NIDcornifleur/RB2/maps_2026-06-20/rb2_map_20260620-125016.png

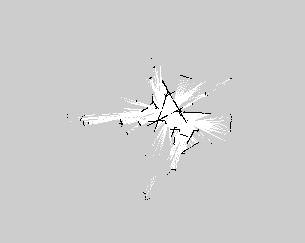
maps_2026-06-20/rb2_map_20260620-125016.png
