NIDcornifleur/RB2/docs/VERIFICATIONS_CODE_20260626.md

\# Vérifications code RB2 - 2026-06-26

\## Objectif

Documenter les vérifications effectuées pendant le nettoyage prudent du dépôt RB2.

Branche utilisée :

\- nettoyage-codex-20260626

\## Vérification syntaxique Python

Les fichiers suivants ont été vérifiés avec python -m py\_compile :

\- opt/rb2/esp32\_panel.py

\- opt/rb2/rb2\_esp32.py

\- opt/rb2/rb2\_lidar\_json.py

\- opt/rb2/rb2\_lidar\_map\_json.py

\- opt/rb2/rb2\_imu\_json.py

\- opt/rb2/rb2\_usb\_camera.py

\- opt/rb2/rb2\_wifi\_dual\_loss\_return.py

Résultat :

\- aucune erreur bloquante;

\- les fichiers compilent.

\## Avertissement corrigé ou déjà résolu

Un avertissement Python avait été observé dans opt/rb2/esp32\_panel.py :

\- SyntaxWarning: invalid escape sequence '\\d'

Ligne JavaScript concernée :

\- return /^d-?\\d+,-?\\d+$/.test(String(command || ""));

État final vérifié :

\- return /^d-?\\\\d+,-?\\\\d+$/.test(String(command || ""));

Cette forme évite l'avertissement Python tout en conservant le sens de l'expression régulière JavaScript générée.

\## État Git final

Après vérification :

\- git status propre;

\- aucun fichier \_\_pycache\_\_ conservé;

\- aucun changement non commité.

\## Conclusion

Le dépôt est dans un état propre après les vérifications syntaxiques.

Aucune logique moteur, STOP, LIDAR, SLAM, caméra, trace ou réseau n'a été modifiée volontairement.
