NIDcornifleur/RB2/docs/VALIDATION_2026-06-20_SLAM_TERRAIN_OK.md

# Validation RB2 — Parcours SLAM terrain réussi

Date : 2026-06-20

## Résultat

Petit parcours SLAM effectué avec succès depuis la page Terrain.

État confirmé :

- Démarrage SLAM depuis les boutons existants de la page Terrain
- Trace démarrée
- Parcours effectué sans hésitation
- Aucun délai anormal moteur ou pan-tilt
- Carte sauvegardée
- PNG téléchargé avec succès

## Conclusion

La chaîne SLAM manuelle est fonctionnelle pour un petit parcours terrain :

/scan
/imu
/wheel_ticks
/odom
slam_toolbox
/map
sauvegarde carte
téléchargement PNG

Cet état est considéré comme stable.
