NIDcornifleur/RB2/docs/VALIDATION_DEPLOIEMENT_PI5_20260626.md

# Validation déploiement Pi5 RB2 - 2026-06-26

## Contexte

Déploiement sur le Pi5 RB2 après fusion du nettoyage Codex prudent dans main.

Commit validé :

- 796d383 Fusionne nettoyage Codex prudent RB2

Tag main :

- rb2-main-apres-nettoyage-codex-20260626

## Sauvegarde préalable

Une sauvegarde de production a été faite avant déploiement :

- /opt/rb2_backups/rb2_avant_main_nettoyage_20260626

## Résultat après déploiement

Fonctions validées :

- caméra : OK
- pan/tilt : OK
- lumières : OK
- relais : OK
- LIDAR : OK
- roues : OK

Fonction connue comme instable :

- IMU : inactif/intermittent, remplacement prévu

## Conclusion

Le déploiement du nettoyage Codex prudent sur le Pi5 est validé.

Aucun rollback nécessaire.

Le dépôt main et /opt/rb2 sont considérés comme conformes après validation terrain de base.
