NIDcornifleur/RB2/docs/VALIDATION_2026-06-20_SLAM_TERRAIN_PNG_OK.md

# Validation RB2 — SLAM terrain avec téléchargement PNG OK

Date : 2026-06-20

## État validé

Le parcours terrain avec SLAM manuel a été réussi.

État ROS confirmé avant parcours :

- slam_toolbox : active [3]
- /scan présent
- /imu présent
- /odom présent
- /map présent
- /map_metadata présent
- /pose présent
- /slam_toolbox/scan_visualization présent

## Interface web

Page utilisée :

- /terrain

Boutons utilisés :

- DÉMARRER SLAM
- DÉMARRER TRACE, si utilisé
- SAUVEG.
- TÉLÉCH. PNG
- ARRÊTER TRACE, si utilisé

Résultat :

- carte générée;
- PNG téléchargé avec succès;
- parcours SLAM fonctionnel.

## Correction importante

La route /slam_start a été simplifiée pour éviter de bloquer l'interface web.

Ancien comportement :

- /slam_start attendait trop longtemps la configuration complète de slam_toolbox;
- le navigateur pouvait dépasser 45 secondes;
- les boutons SLAM/CARTE restaient gelés jusqu'au rafraîchissement.

Nouveau comportement :

- /slam_start lance /usr/local/sbin/rb2-slam-start-bg en arrière-plan;
- la réponse web revient rapidement;
- /slam_status continue de suivre l'état réel du SLAM;
- slam_toolbox finit en active [3].

## Fichiers sauvegardés

- /opt/rb2/esp32_panel.py
- /usr/local/sbin/rb2-slam-start-bg
- /etc/sudoers.d/rb2-slam-start-bg
- cartes du jour dans maps_2026-06-20/

## État recommandé pour les prochains essais

- utiliser le mode terrain AP seulement;
- vérifier que slam_toolbox est active [3] avant de rouler;
- conduire lentement;
- faire des pauses de 1 seconde entre les mouvements;
- éviter les grands pivots rapides pendant les validations SLAM.
