NIDcornifleur/RB2/(commit log)

2026-06-18 État stable RB2 caméra Ethernet et LIDAR OK
2026-06-18 Ajoute code source ESP32 RB2
2026-06-19 Etat stable apres limites pan camera et retour avertissement LIDAR
2026-06-19 Corrige limites pan tilt ESP32
    [RB2_ESP32_WROOM_Moteurs_PanTilt_Encodeurs.ino]
2026-06-20 Valide SLAM manuel et pont wheel ticks JSON
2026-06-20 Ajoute bouton Restart Camera pour Zero 2 W
2026-06-26 Ajoute inventaire de nettoyage Codex
2026-06-26 Documente empreintes SHA256 des dossiers opt
2026-06-26 Ajoute preuve production lidar map json
2026-06-26 Ajoute version production lidar map json dans opt rb2
2026-06-26 Ajoute scripts systemd de production
2026-06-26 Corrige modes executables des scripts RB2
    [rb2_lidar_map_json.py]
2026-06-26 Ajoute rapport de nettoyage structurel
2026-06-26 Documente analyse esp32_panel
2026-06-26 Documente routes Flask esp32_panel
2026-06-26 Documente constantes sensibles esp32_panel
2026-06-26 Documente dependances esp32_panel
2026-06-26 Ajoute module ESP32 de production
2026-06-26 Documente module ESP32 de production
2026-06-26 Documente micro-corrections esp32_panel
2026-06-26 Ajoute watchdog LIDAR ROS
2026-07-06 Ajoute lidar_drive2 avec boutons sous carte et panneau compact
2026-07-06 Remplace pont IMU par lecture BNO055
2026-07-12 Route LIDAR controls to lidar_drive2
2026-07-14 Intègre /terrain4 dans l'arborescence canonique et corrige ses bugs
    - opt/rb2/esp32_panel.py : ajoute la route /terrain4 (page autonome,
    déjà en production, jamais synchronisée avec le dépôt).
    - opt/rb2/terrain4.html (nouveau) : remplace les copies non suivies
    terrain4.html et esp32_panel_RB2_terrain4.py à la racine.
    - Corrige fetchJson() qui référençait une variable "started" jamais
    déclarée, provoquant une erreur sur chaque appel (lumière, relais 2,
    carte LIDAR, statut vidéo) malgré des réponses serveur valides.
    - Applique le correctif réseau v2.1 (délais rallongés, resynchronisation
    GPIO, carte LIDAR à 2 s).
    - Réorganise l'en-tête : lumière/relais 2/arrêt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
2026-07-14 Ajoute un bouton RETOUR vers /terrain4 sur /lidar_drive2
    Le bouton est placé à côté du badge « RB2 : OK » dans le panneau État
    RB2, qui est rétréci pour lui laisser la place. Changement scopé à la
    route /lidar_drive2 (ne touche pas /lidar_drive, qui partage le même
    gabarit de base LIDAR_DRIVE_HTML).
    Testé et validé en direct sur RB2.
2026-07-14 Corrige le lien Retour de /secours vers /terrain4
    Les deux liens "Retour /terrain" de la page /secours pointaient encore
    vers l'ancienne page /terrain. Mis à jour vers /terrain4.
    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
2026-07-14 Reconnaît /terrain4 dans le nettoyage des doublons Retour sur /secours
    isTerrainReturn() ne reconnaissait que href === "/terrain" pour
    détecter et retirer les liens "Retour terrain" en double hors de la
    barre de titre. Depuis le passage de ces liens vers /terrain4, le
    doublon n'était plus nettoyé côté client.
    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
2026-07-14 Rétablit le glissement entre boutons moteur sur terrain4
    Avant, il fallait relâcher un bouton moteur puis en cliquer un autre
    pour changer de direction. Les pages précédentes (lidar_drive2)
    permettaient de glisser d'un bouton à l'autre sans décliquer via
    elementFromPoint sur mousemove/touchmove ; terrain4 avait perdu cette
    logique en passant à pointerdown/pointerup + setPointerCapture.
    Ajoute un gestionnaire pointermove par bouton qui détecte, via
    elementFromPoint, le bouton survolé et change de direction seulement
    si elle diffère de la direction active (state.driveDirection).
2026-07-18 Ajoute la bascule Wi-Fi 2,4G/5G sur terrain4 avec retour visuel
    Boutons wifi24gBtn/wifi5gBtn : script rb2-wifi-mode (wifi_24g/wifi_5g),
    routes /rb2_network/wifi_24g et /wifi_5g, et détection SSID/bande
    (iwgetid avec repli nmcli) exposée par /rb2_network/status. Le bouton
    actif passe en vert; un clic sonde le statut jusqu'à confirmation de
    la bande (jusqu'à 20 s, la ré-association + DHCP n'étant pas
    instantanés) avant d'afficher ERREUR en cas d'échec réel.
2026-07-21 Corrige le double-shutdown rclpy dans les ponts JSON LIDAR
    rb2-lidar-watchdog redémarre ces services via systemctl restart quand
    le JSON devient stale, ce qui envoie SIGTERM. Le handler de signal de
    rclpy invalide alors le contexte avant que le finally: rclpy.shutdown()
    explicite ne s'exécute, provoquant un RCLError ("rcl_shutdown already
    called") et un crash au lieu d'un arrêt propre. 14 crashes observés le
    2026-07-21 entre 08:41 et 09:06, laissant back_cm intermittent/absent
    et bloquant gauche/droite/recul via la garde LIDAR de rb2_safe_drive_send.
    [rb2_lidar_json.py, rb2_lidar_map_json.py]
2026-07-24 terrain4: recharger périodiquement l'image caméra pour purger le lag MJPEG
    Le flux MJPEG en <img> n'a pas de saut d'image : quand lidarMapLoop
    (fetch+dessin toutes les 2s) occupe le thread JS, le décodage prend du
    retard qui grandit indéfiniment jusqu'au reload manuel. Ajoute un
    rechargement auto toutes les 20s (10 ticks de lidarMapLoop).
2026-07-24 terrain4: visionneuse caméra "dernière image seulement" pour éliminer le lag MJPEG
    Le correctif précédent (rechargement périodique de l'<img>) s'est révélé
    insuffisant en test réel : le lag se reconstituait plus vite qu'il n'était
    purgé. Cause racine : multipart/x-mixed-replace n'a aucun mécanisme de
    saut d'image, donc tout retard de décodage s'accumule indéfiniment tant
    que la connexion reste ouverte.
    Remplace le <img> par un <canvas> piloté en JS : lecture du flux via
    fetch()+ReadableStream, découpage des trames JPEG par marqueurs SOI/EOI,
    et décodage/affichage systématique de la dernière trame complète
    disponible uniquement (les plus anciennes en attente sont jetées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
2026-07-24 Retirer le bouton 2,4G de terrain4 (devenu inutile)
    Garde le bouton 5G seul, sur toute la largeur de sa rangée.
2026-07-25 Fix lidar watchdog restart-storm: longer cooldown + circuit breaker after bringup restarts
    The watchdog used a single 45s cooldown for both a light bridge-only restart
    and a full rb2-bringup restart. A full bringup restart relaunches every ROS2
    node at once (lidar, IMU, wheel ticks, odometry) and DDS discovery needs more
    than 45s to settle, so a still-stale check would trigger another full restart
    before the previous one had a chance to recover -- producing restart storms
    that repeatedly killed wheel_ticks/odometry mid-drive (documented episodes
    2026-07-11 through 2026-07-23, up to 15 consecutive bringup restarts in one
    sitting). This is very likely why the service ended up manually masked o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
    [rb2_lidar_watchdog.py]
2026-07-25 Ajouter un bouton SSID sur terrain4 pour joindre le Wi-Fi d'un client sur site
    RB2 fait des inspections chez des clients ; arriver sur place et pouvoir
    rejoindre leur réseau local (au lieu de dépendre uniquement du hotspot RB2)
    demandait jusqu'ici une intervention manuelle en ligne de commande.
    - terrain4.html : bouton SSID à côté du bouton 5G (rangée à deux colonnes de
    nouveau), ouvre une fenêtre modale avec deux champs (SSID, mot de passe).
    - esp32_panel.py : route /rb2_network/connect_ssid, valide les entrées et
    délègue à rb2-wifi-mode via sudo -n (déjà dans la liste NOPASSWD).
    - rb2-wifi-mode : nouvelle action connect_ssid, utilise nmcli device wifi
    connect (gère aj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
2026-07-25 Fix: connect_ssid faussait toujours un succès + ajoute confirmation post-connexion
    rb2-wifi-mode se termine par un "exit 0" général après le bloc case, qui
    écrasait le vrai code de sortie de connect_ssid : même un échec nmcli réel
    (mauvais mot de passe, SSID hors de portée, etc.) remontait comme un succès
    jusqu'au panneau web. Corrigé en propageant explicitement le code de sortie
    de connect_ssid.
    Ajoute aussi une confirmation côté page après un succès nmcli : RB2 a un
    réseau connu épinglé à priorité élevée (WIFI-MAISON-5G-nanoHD, priorité 10 pour
    l'itinérance), donc NetworkManager peut revenir dessus tout seul quelques
    secondes après une connexion réussie à un nou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
2026-07-25 connect_ssid doit gagner sans discussion : neutralise l'auto-reconnexion des réseaux connus
    Un SSID demandé explicitement par l'opérateur est un ordre, pas une
    préférence parmi d'autres. WIFI-MAISON-5G-nanoHD a un autoconnect-priority=10
    épinglé (pour l'itinérance sur le réseau maison) qui pouvait faire reprendre
    la main à NetworkManager après une connexion réussie à un nouveau SSID si
    les deux réseaux étaient visibles en même temps.
    connect_ssid désactive maintenant l'autoconnect de tous les autres profils
    Wi-Fi connus avant de se connecter, et fixe une priorité maximale (999) sur
    le nouveau profil. bureau/wifi_24g/wifi_5g restaurent l'autoconnect normal :
    ce sont les act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
2026-07-25 Ajouter un bouton DÉCONNEXION pour quitter le Wi-Fi client et revenir au réseau local
    Complète le bouton SSID : une fois l'inspection terminée chez le client, ce
    bouton déconnecte wlan0 du réseau client, réactive l'auto-reconnexion des
    réseaux connus (levée par connect_ssid), et tente activement de rejoindre le
    meilleur réseau local connu disponible.
    - rb2-wifi-mode : nouvelle action disconnect_client ; factorise la logique de
    reconnexion (déjà utilisée par bureau) dans reconnect_local_wifi().
    - esp32_panel.py : route /rb2_network/disconnect_client.
    - terrain4.html : bouton DÉCONNEXION à côté de 5G/SSID (rangée à trois
    colonnes).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
2026-07-26 Ajoute le bouton TILT 145° sur /terrain4
    Restaure le bouton d'inclinaison maximale (145°) qui existait sur
    l'ancienne page terrain/lidar_drive2 mais avait été omis lors de la
    création de terrain4. La rangée CENTRE/TILT passe de 2 à 3 boutons
    (largeur réduite de CENTRE et TILT 68° pour faire place).
2026-08-29 lidar_drive2: ajoute un compteur de distance (trajet + total cumulatif)
    Réutilise l'odométrie encodeurs déjà calculée côté serveur (odom.center_cm
    de /encoders) : accumule la valeur absolue du déplacement à chaque lecture.
    TRAJET est remis à zéro par bouton, TOTAL est cumulatif et persiste en
    localStorage (jamais remis à zéro), comme un compteur journalier vs
    odomètre total sur une auto. Active automatiquement la lecture périodique
    des encodeurs sur cette page (suspendue pendant la conduite active, comme
    déjà prévu par toggleAutoEncoders).
2026-08-29 lidar_drive2: corrige le compteur de distance qui restait à 0
    La lecture des encodeurs est suspendue pendant la conduite active, donc un
    seul trajet continu (ex. ~10m sans relâcher le pad) produit un grand écart
    en une seule lecture après l'arrêt. Le plafond de 5m ajouté par erreur pour
    filtrer les sauts liés à une RAZ encodeurs/redémarrage ESP32 rejetait donc
    aussi les vrais trajets. Retire ce plafond et gère la RAZ encodeurs
    matérielle proprement en réinitialisant le point de référence du compteur
    quand resetEncoders() est appelé.
2026-08-29 installer_terrain4.sh: attend que le panneau réponde avant de valider
    Le service met parfois ~7s à démarrer (Flask + initialisations) alors que
    le script ne laissait que 3s avant de vérifier /terrain4, déclenchant une
    restauration automatique du backup malgré une installation réussie
    (observé en prod 2026-08-29 lors du déploiement du compteur de distance
    lidar_drive2). Remplace le sleep fixe par une boucle d'attente jusqu'à 20s.
2026-08-29 lidar_drive2: le compteur de distance lit enfin de vraies données
    Root cause: lidar_drive2 n'a jamais eu de readEncoders/updateEncoderDisplay/
    autoEncoders — ce JS appartient à une page totalement différente (l'ancienne
    page "Test ESP32"). Les hooks précédents ne faisaient donc rien, peu importe
    la distance parcourue: le compteur restait figé à 0.
    Remplace ça par une boucle de lecture autonome sur /lidar_drive2 lui-même:
    - interroge /encoders toutes les 5s (odom.center_cm)
    - saute la lecture si /wifi_return_status.last_drive_time indique une
    commande moteur envoyée il y a moins de 1.5s, peu importe l'onglet
    d'origine (le serveur Flask est mono-thread et /encoders bloque jusq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
2026-08-29 Ajoute au dépôt l'état déployé du secours Zero (auto.py + service)
    rb2_zero_secours_auto.py et son unité systemd tournaient sur le Zero sans
    être versionnés. On les capture tels quels avant de les corriger.
    Claude-Session: https://claude.ai/code/session_01V9v2REhfLhKhZKpTYeb7Pc
2026-08-29 Secours Wi-Fi : auto-réparation du PA RB2-ROS + retour automatique du secours Zero
    Trois correctifs à l'incident du 2026-08-29 (RB2-ROS muet après reset USB du
    dongle Alfa ; le Zero reste bloqué sur RB2-ZERO-SECOURS ; bouton « Restart
    retour Wi-Fi » trompeur).
    1. rb2_ap_watchdog.py + rb2-ap-watchdog.service (Pi5)
    Détecte un hostapd orphelin (interface DOWN / sans SSID / sans IP alors
    que le service est « active ») et relance rb2-ap-ip.service puis
    hostapd.service. Coupe-circuit après 4 réparations rapprochées.
    2. rb2_zero_secours_auto.py (Zero)
    Ajoute le retour au réseau local : quand un Wi-Fi du Pi5 est revenu
    pendant ~60 s, rabaisse RB2-ZERO-SECOURS, remet aut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
    [rb2_ap_watchdog.py]
2026-08-29 docs secours wifi : note le déploiement effectif du chien de garde (interim ~/rb2_scripts)
    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
2026-08-29 docs secours wifi : acte le déploiement complet (chien de garde migré /opt/rb2, Zero à jour)
    - « État du déploiement » : les 3 correctifs déployés et vérifiés en direct,
    fichiers identiques au tip de branche ; chien de garde migré hors de
    ~/rb2_scripts vers /opt/rb2 + unité systemd propre.
    - sudoers : Zero = rb2-zero-secours-local (OK) ; Pi5 = inutile (systemctl
    déjà NOPASSWD global).
    - Test de non-régression réécrit : masquer le chien de garde PA pendant le
    test, constantes réelles (6×10 s), noms de logs exacts, étape bouton
    « COUPER secours Zero ».
    Claude-Session: https://claude.ai/code/session_01Uccf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
2026-08-30 Arrêt complet : tilt 145° avant coupure + ssh Zero fiable (accept-new)
    rb2_shutdown_worker() (seul point derrière /system_shutdown_all, donc tous
    les boutons ARRÊT) :
    1. Positionne le pan à 95° puis le tilt à 145° (position de rangement) et
    laisse 1,5 s au servo avant de couper l'alimentation. Reprend le correctif
    de la branche tilt-145-avant-shutdown (dc33dad), jamais fusionnée.
    2. Ajoute -o StrictHostKeyChecking=accept-new aux 4 commandes ssh vers le
    Zero (10.50.0.20). En BatchMode, si la clé d'hôte du Zero est absente de
    known_hosts (fichier vidé, Zero ré-imagé/nouvelle carte SD), ssh échoue
    sur « Host key verification failed » : le Zero ne reçoit jamais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
2026-09-07 lidar_drive2: odomètre de distance calculé et persisté côté serveur
    Le compteur TRAJET/TOTAL de /lidar_drive2 restait à 0. Causes cumulées de
    l'ancienne version (localStorage navigateur + poll /encoders) :
    - état par navigateur / origine / cache : perdu dès qu'on change d'appareil
    ou qu'on accède par IP au lieu de rb2-ros.local ;
    - ne comptait que si /lidar_drive2 restait ouvert pendant toute la conduite ;
    - le garde-fou "commande moteur < 1,5 s" sautait TOUTES les lectures pendant
    que le robot roulait -> ne mesurait que le déplacement net entre deux arrêts
    (les virages et allers-retours s'annulent) ;
    - center_cm vient des compteurs de ticks bruts de l'ESP32, remis à zéro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
2026-09-13 Fix: BNO055 reste en ok:true meme retombe en CONFIGMODE
    Après une coupure/glitch d'alimentation (ex: manipulation du câblage),
    le chip peut revenir en CONFIGMODE sans qu'aucune lecture I2C n'échoue.
    Le service continuait à répondre ok:true avec roll/pitch/accel/gyro figés
    à zéro, sans jamais remonter d'erreur côté page /lidar_drive2 (niveau
    visuellement figé, aucun message d'erreur affiché).
    La boucle de lecture vérifie maintenant OPR_MODE et sys_stat à chaque
    itération et force une réinitialisation (via le mécanisme d'erreur/retry
    déjà en place dans main()) si le capteur a dérivé de son mode de service.
    Claude-Se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
    [rb2_imu_json.py]
2026-09-15 Add VL53L1X/VL53L5CX I2C address reassignment via GPIO17 (LPn)
    Both sensors default to 0x29 and collide on i2c-1. VL53L5CX's LPn is
    now wired to GPIO17: hold it low to isolate the VL53L1X, reassign the
    VL53L1X to 0x2A via its I2C_SLAVE_DEVICE_ADDRESS register, then release
    GPIO17 so the VL53L5CX boots at 0x29. Tested live on i2c-1: 0x28
    (BNO055), 0x29 (VL53L5CX), 0x2A (VL53L1X) all present simultaneously.
    Runs as a resident systemd service (not one-shot) to keep holding
    GPIO17 high, since no hardware pull-up on that pin is confirmed yet.
    [rb2_tof_addr_init.py]
2026-09-15 Fix rb2-tof-addr-init: WorkingDirectory=/opt/rb2 blocks lgpio's notify pipe
    lgpio creates a .lgd-nfyN notification pipe in the process cwd on import.
    /opt/rb2 is root-owned (rj can't write there), so the service crash-looped
    immediately on `import lgpio`. Switched WorkingDirectory to /tmp, which is
    writable and matches what lgpio actually needs it for (ExecStart already
    uses an absolute path to the script, so no other behavior depends on cwd).
2026-09-15 Make VL53L1X address reassignment idempotent across service restarts
    The VL53L1X's I2C address register only resets on a real power cycle,
    not on a systemd service restart. Without this check, restarting the
    service after a successful reassignment logged a false "timeout" error
    (it looked for the sensor at the old 0x29, but it now answers at 0x2A)
    before falling back to a safe end state. Now it short-circuits cleanly
    when the sensor is already found at its target address.
    [rb2_tof_addr_init.py]
2026-09-15 Add JSON bridges to read VL53L1X and VL53L5CX distance detections
    Both sensors are now distinguishable on i2c-1 (0x2A / 0x29) thanks to
    rb2-tof-addr-init.service. This adds two resident services, mirroring
    rb2_imu_json.py's pattern: read distances continuously, write them as
    atomic JSON to /tmp for other RB2 processes to consume.
    - rb2_vl53l1x_json.py: single-point distance (LONG mode) -> /tmp/rb2_vl53l1x.json
    - rb2_vl53l5cx_json.py: 4x4 multizone grid -> /tmp/rb2_vl53l5cx.json
    Both tested live against the physical sensors. Requires the pip packages
    vl53l1x and vl53l5cx-ctypes (installed --user --break-system-packages,
    same pattern already used for smbus2/lgpio on this Pi).
    Co-Authored-By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
2026-09-15 Fix boot-order race between rb2-tof-addr-init and the VL53 JSON bridges
    Type=simple only guarantees rb2-tof-addr-init.service's process has been
    launched, not that its GPIO17/I2C address reassignment sequence has
    finished, so rb2-vl53l1x-json/rb2-vl53l5cx-json (After=/Requires= on it)
    could start and probe the bus before addresses were stable. Observed live
    at boot 2026-09-15 13:43:10-11: both failed immediately ("not found on
    address 2a" / "not detected on 0x29").
    Switch to Type=notify with an sd_notify(READY=1) call once the address
    sequence completes (success or failure - GPIO17 is already in its final
    state either way), so systemd holds dependent units until it's actually
    safe to probe.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
    [rb2_tof_addr_init.py]
2026-09-15 Remplace la lib VL53L1X Pimoroni par adafruit-circuitpython-vl53l1x
    La lib Pimoroni fait un poll bloquant côté extension C en attendant
    chaque mesure, ce qui gèle i2c-1 au niveau matériel en quelques
    secondes (TimeoutError Errno 110), récupérable seulement par un
    débranchement/rebranchement physique du capteur. La lib Adafruit lit
    les registres directement via smbus sans poll bloquant caché.
2026-09-15 Fix rb2-vl53l1x-json.service: WorkingDirectory doit être inscriptible
    La lib Adafruit CircuitPython tire lgpio (via Blinka) même pour un
    simple accès I2C sur Pi 5, et lgpio ouvre un fichier de notification
    relatif au répertoire courant. Avec WorkingDirectory=/opt/rb2
    (root-only), ça plantait au démarrage: FileNotFoundError sur
    .lgd-nfy-N. Même correctif que rb2-tof-addr-init.service (PR #24):
    WorkingDirectory=/tmp.
2026-09-15 Ajoute alarme visuelle détection d'eau sur /lidar_drive2 (ToF sol+plafond)
    Nouvelles routes /vl53l1x_json et /vl53l5cx_json (même pattern que
    /imu_json: stat+age, lecture JSON, jsonify ok/age_s/data).
    Le rôle réel du VL53L1X (sous le RB2) et du VL53L5CX (au plafond) est
    de détecter une présence d'eau, pas l'évitement d'obstacle: ligne "EAU"
    ajoutée dans le panneau ld2-bars, avec alarme visuelle (fond rouge +
    clignotement) si la distance mesurée s'écarte significativement de la
    référence à sec (~60mm sol, ~600mm plafond) ou si la lecture reste
    invalide plus de 3s (l'eau perturbe souvent le retour du laser ToF).
2026-09-16 Bascule les capteurs ToF (VL53L1X/VL53L5CX) sur i2c-3 bit-bangé
    Le contrôleur matériel DesignWare de i2c-1 se bloquait ("controller timed
    out" au dmesg) de façon récurrente et sans déclencheur identifiable, malgré
    deux correctifs déjà tentés (remplacement de lib côté VL53L1X dans #26,
    re-soudure des connexions physiques) - récupérable seulement par un
    débranchement/rebranchement physique des capteurs.
    Passe les deux capteurs ToF sur un bus i2c-gpio bit-bangé logiciel (bus 3,
    GPIO23/24 via overlay dtoverlay=i2c-gpio,bus=3), qui gère le stretching
    d'horloge côté noyau et permet une récupération de bus sans cycle
    d'alimentation physique. Le BNO055 reste sur i2c-1 matériel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
    [rb2_tof_addr_init.py, rb2_vl53l1x_json.py, rb2_vl53l5cx_json.py]
2026-09-16 Assouplit Requires en Wants pour les services ToF (dépend de rb2-bringup)
    Evite qu'un rb2-bringup.service en échec fasse aussi échouer les services
    ToF en cascade (Requires bloque le démarrage si la dépendance échoue,
    Wants non).
2026-09-17 Ajoute un watchdog pour les ToF sol/plafond (VL53L1X/VL53L5CX)
    Après un gel i2c-1, redémarrer rb2-esp32-panel.service ne restaure pas
    les capteurs ToF sol (VL53L1X) et plafond (VL53L5CX) car ce service ne
    lit que les ponts JSON, sans toucher l'I2C. Le 2026-09-17, un simple
    redémarrage des deux services rb2-vl53l1x-json/rb2-vl53l5cx-json a
    suffi à réparer les ToF, sans débranchement physique.
    Ce watchdog, sur le même modèle que rb2-lidar-watchdog.py, surveille
    la fraîcheur de /tmp/rb2_vl53l1x.json et /tmp/rb2_vl53l5cx.json et
    redémarre automatiquement, par étapes croissantes (ponts JSON, puis
    rb2-tof-addr-init), avec cooldowns et disjoncteur après échecs
    répétés.
    Co-Authored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
2026-09-17 Découple les services ToF de rb2-bringup.service (Requires -> After)
    rb2-bringup.service échoue systématiquement au premier essai au
    démarrage (KeyboardInterrupt dans _local_setup_util.py de ROS2, cause
    distincte non traitée ici) et se rétablit ~2s plus tard via
    Restart=on-failure. rb2-tof-addr-init.service, rb2-vl53l1x-json.service
    et rb2-vl53l5cx-json.service avaient Requires=rb2-bringup.service : cet
    échec transitoire de bringup déclenche l'arrêt en cascade de tout le
    chemin ToF (Requires stoppe les dépendants quand la dépendance tombe),
    et rien ne les relance automatiquement quand bringup redevient actif -
    d'où les capteurs ToF non démarrés après chaque redémarrage, obser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
2026-09-17 Retire le Requires->Wants ToF de cette branche, doublon avec PR #30
    Le commit 3796991 assouplissait Requires=rb2-bringup.service en Wants=
    sur les 3 services ToF pour éviter l'arrêt en cascade au boot - même
    motivation que PR #30 (fix-tof-bringup-requires-cascade), mais cette
    branche datant d'avant le fix sd_notify (PR #24/#28) n'avait jamais été
    rebasée sur main, donc son rb2-tof-addr-init.service avait aussi perdu
    Type=notify/NotifyAccess/TimeoutStartSec en la comparant à main - une
    régression involontaire qui aurait réintroduit la race de démarrage déjà
    corrigée.
    Le merge de main qui précède ce commit récupère le fix sd_notify. Ce
    commit revient ensuite les 3 fichiers sy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
2026-09-18 terrain4: cadre caméra à la hauteur exacte du 16:9 (sans bandes noires)
2026-09-18 terrain4: bandeau d'état sous la caméra (capteurs, Wi-Fi, inclinaison, EAU sol/plafond)
    Bloc isolé (marqueurs INFO-PANEL), retrait = git revert de ce commit.
2026-09-18 terrain4: horizon artificiel + niveaux roulis/tangage à la place des chiffres IMU
2026-09-18 terrain4: SOL/PLAFOND à la taille des autres pastilles, retrait de la grille ToF 4x4
2026-09-18 terrain4: SOL sans alarme, alarme PLAFOND à 70 mm et moins
2026-09-30 Ajoute la licence MIT, le lien du sous-module LIDAR et une note sur la copie publique
